hlbrooks/FireBot/PCB_docs/new_boardforfirebot.brd

## EAGLE design PCB_docs/new_boardforfirebot.brd (2021-12-12)

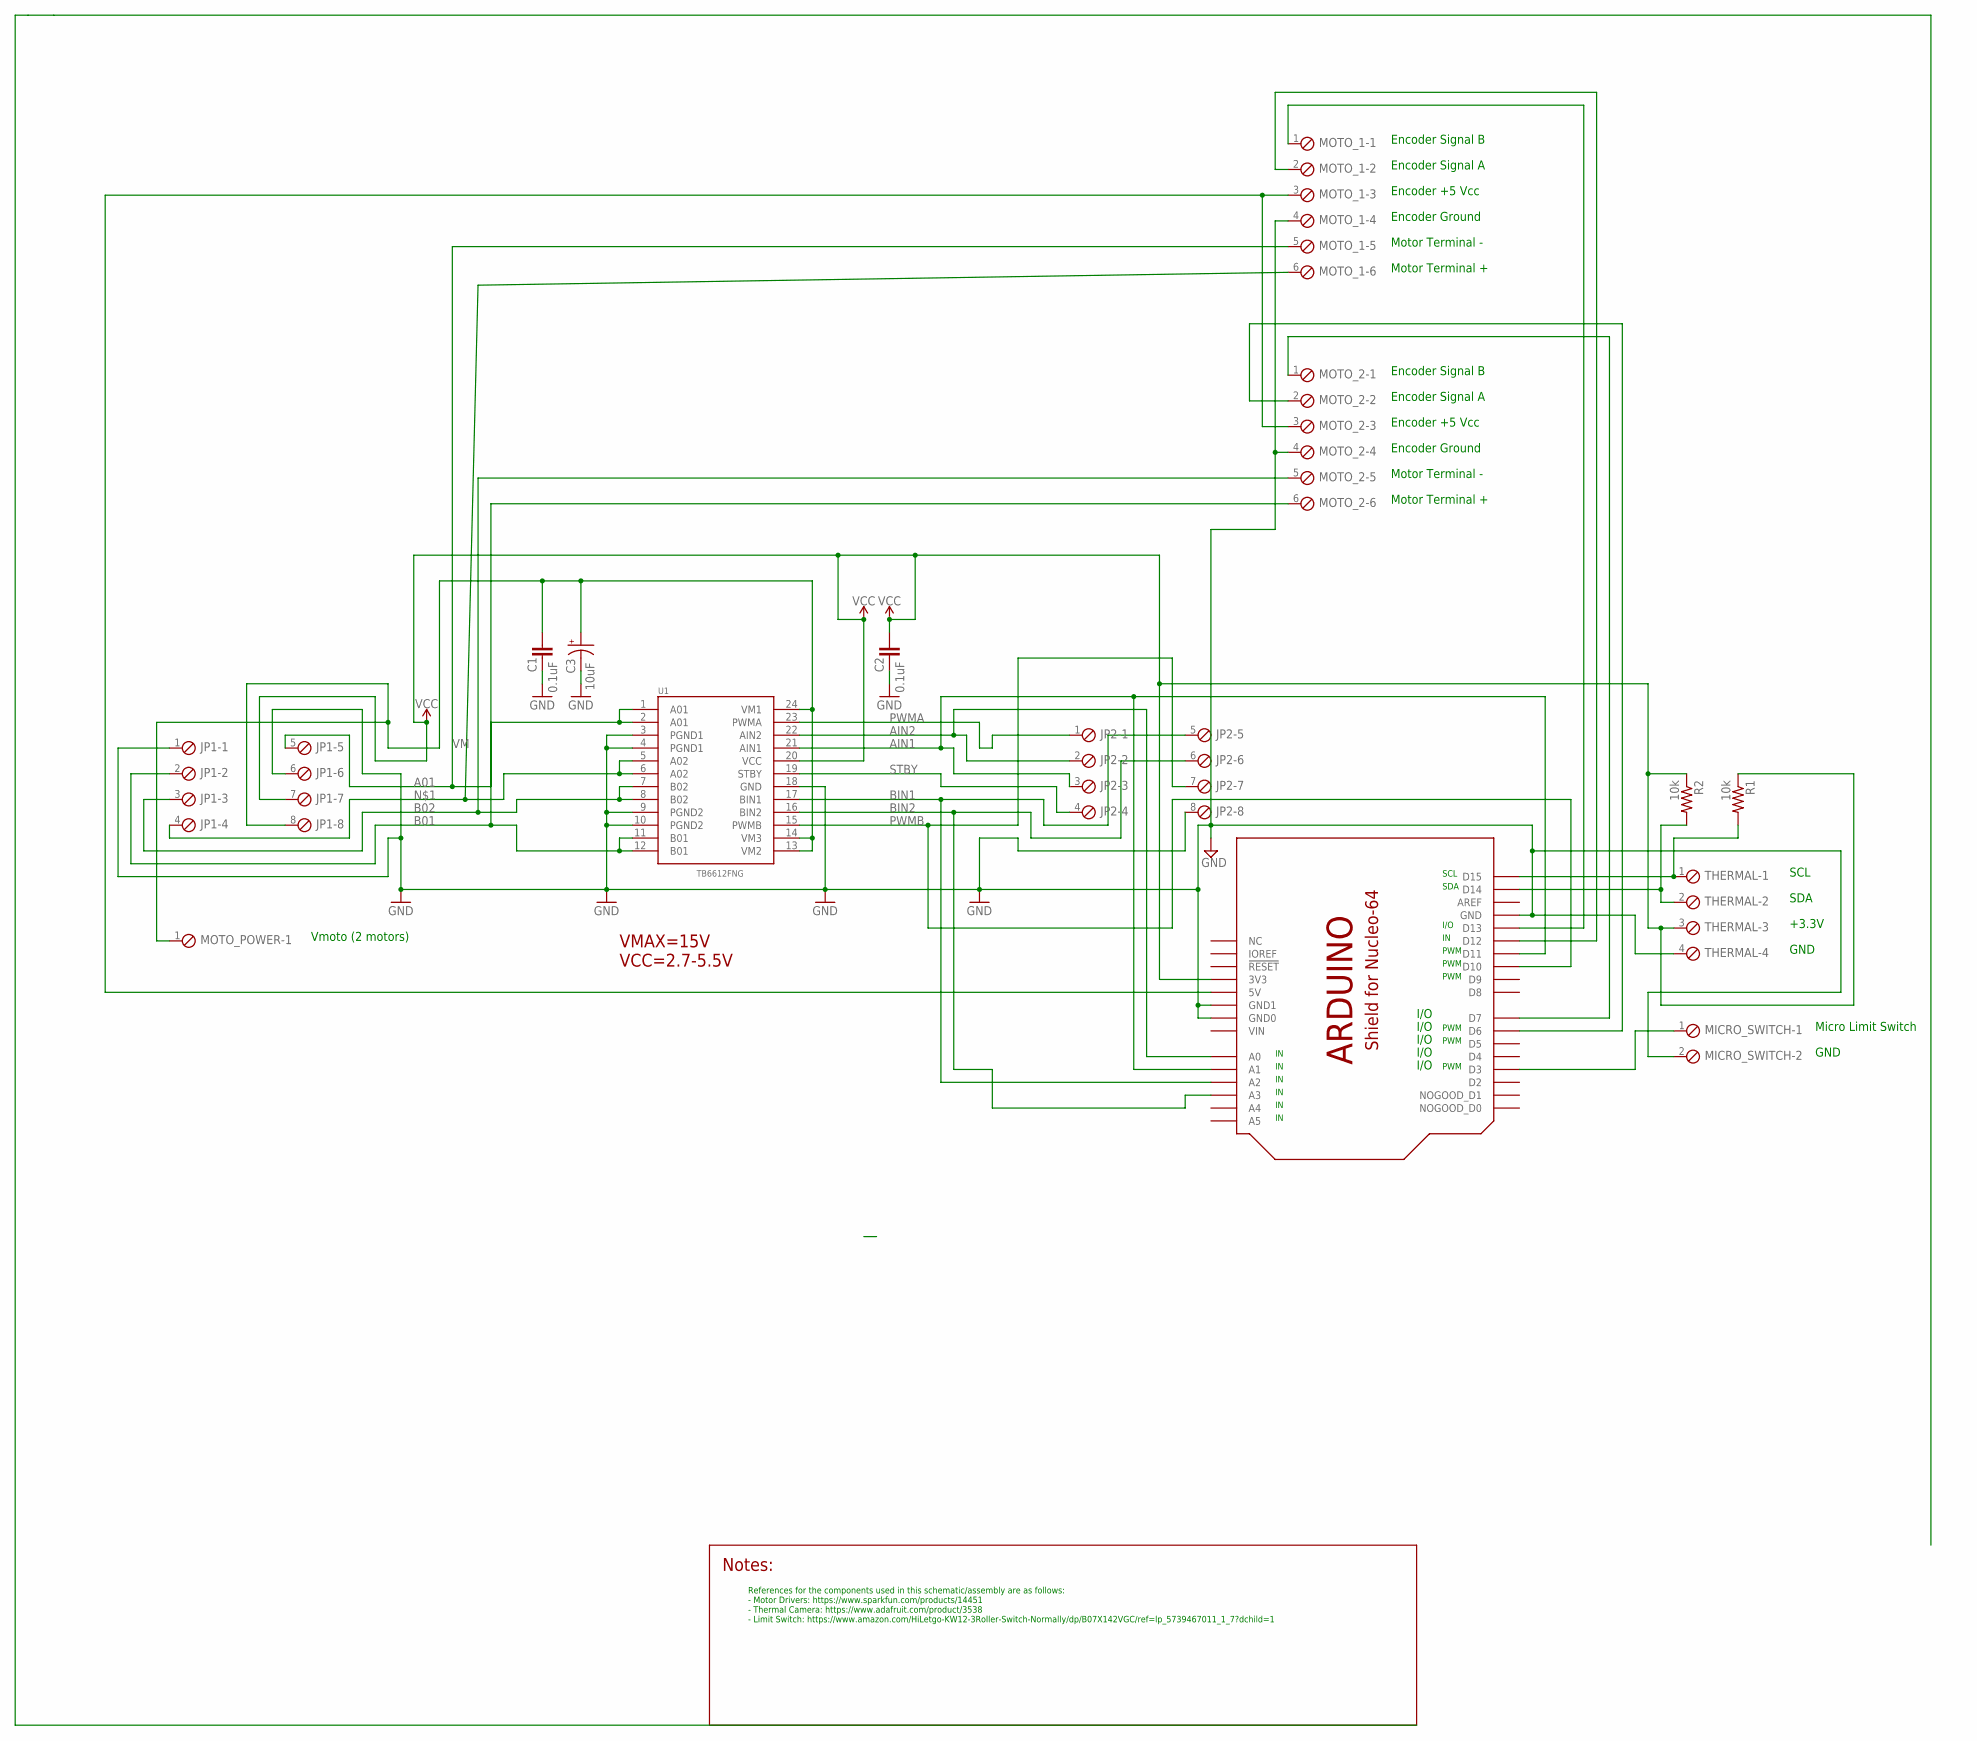
[picture p1: schematic new_boardforfirebot.sch]

Parts:
C1, C2: 0.1uF; 0402
C3: 10uF; EIA3528
JP1, JP2: SCREWTERM_8P_254; 8POL254
MICRO_SWITCH: SCREWTERM_2P_254; 2POL254
MOTO_1, MOTO_2: SCREWTERM_6P_254; 6POL254
MOTO_POWER: SCREWTERM_2P_254; 2POL254
R1, R2: 10k; R0805
THERMAL: SCREWTERM_4P_254; 4POL254
U1: TB6612FNG; SSOP24
U$1: SHIELD_FOR_NUCLE0_64_STANDARD; SHIELD_FOR_NUCLEO_64_STD

Connections:
A01: JP1.5, MOTO_1.5, U1.1 (A01), U1.2 (A01)
AIN1: JP2.3, U1.21 (AIN1), U$1.A1, U$1.D11
AIN2: JP2.2, U1.22 (AIN2), U$1.A0
B01: JP1.2, MOTO_2.6, U1.11 (B01), U1.12 (B01)
B02: JP1.3, MOTO_2.5, U1.7 (B02), U1.8 (B02)
BIN1: JP2.5, U1.17 (BIN1), U$1.A2
BIN2: JP2.6, U1.16 (BIN2), U$1.A3
GND: C1.2, C2.2, C3.C (-), JP1.1, JP1.6, JP2.8, MICRO_SWITCH.2, MOTO_1.4, MOTO_2.4, THERMAL.4, U1.3 (PGND1), U1.4 (PGND1), U1.9 (PGND2), U1.10 (PGND2), U1.18 (GND), U$1.GND, U$1.GND1 (GND0), U$1.GND2 (GND1)
unnamed: JP1.4, MOTO_1.6, U1.5 (A02), U1.6 (A02)
unnamed: MOTO_1.3, MOTO_2.3, U$1.5V
unnamed: MOTO_1.1, U$1.D13
unnamed: MOTO_1.2, U$1.D12
unnamed: MOTO_2.1, U$1.D7
unnamed: MOTO_2.2, U$1.D6
unnamed: R1.2, THERMAL.1, U$1.D15
unnamed: MICRO_SWITCH.1, U$1.D3
unnamed: R2.2, THERMAL.2, U$1.D14
PWMA: JP2.1, U1.23 (PWMA)
PWMB: JP2.7, U1.15 (PWMB), U$1.D10
STBY: JP2.4, U1.19 (STBY)
VCC: C2.1, JP1.7, R1.1, R2.1, THERMAL.3, U1.20 (VCC), U$1.3V (3V3)
VIN: U$1.VIN
VM: C1.1, C3.A (+), JP1.8, MOTO_POWER.1, U1.13 (VM2), U1.14 (VM3), U1.24 (VM1)

Notes on the sheet:
VMAX=15V VCC=2.7-5.5V
Encoder Signal B
Encoder Signal A
Encoder +5 Vcc
Encoder Ground
Motor Terminal -
Motor Terminal +
Vmoto (2 motors)
PWM
SCL
SDA
I/O
+3.3V
GND
Micro Limit Switch
References for the components used in this schematic/assembly are as follows: - Motor Drivers: https://www.sparkfun.com/products/14451 - Thermal Camera: https://www.adafruit.com/product/3538 - Limit Switch: https://www.amazon.com/HiLetgo-KW12-3Roller-Switch-Normally/dp/B07X142VGC/ref=lp_5739467011_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

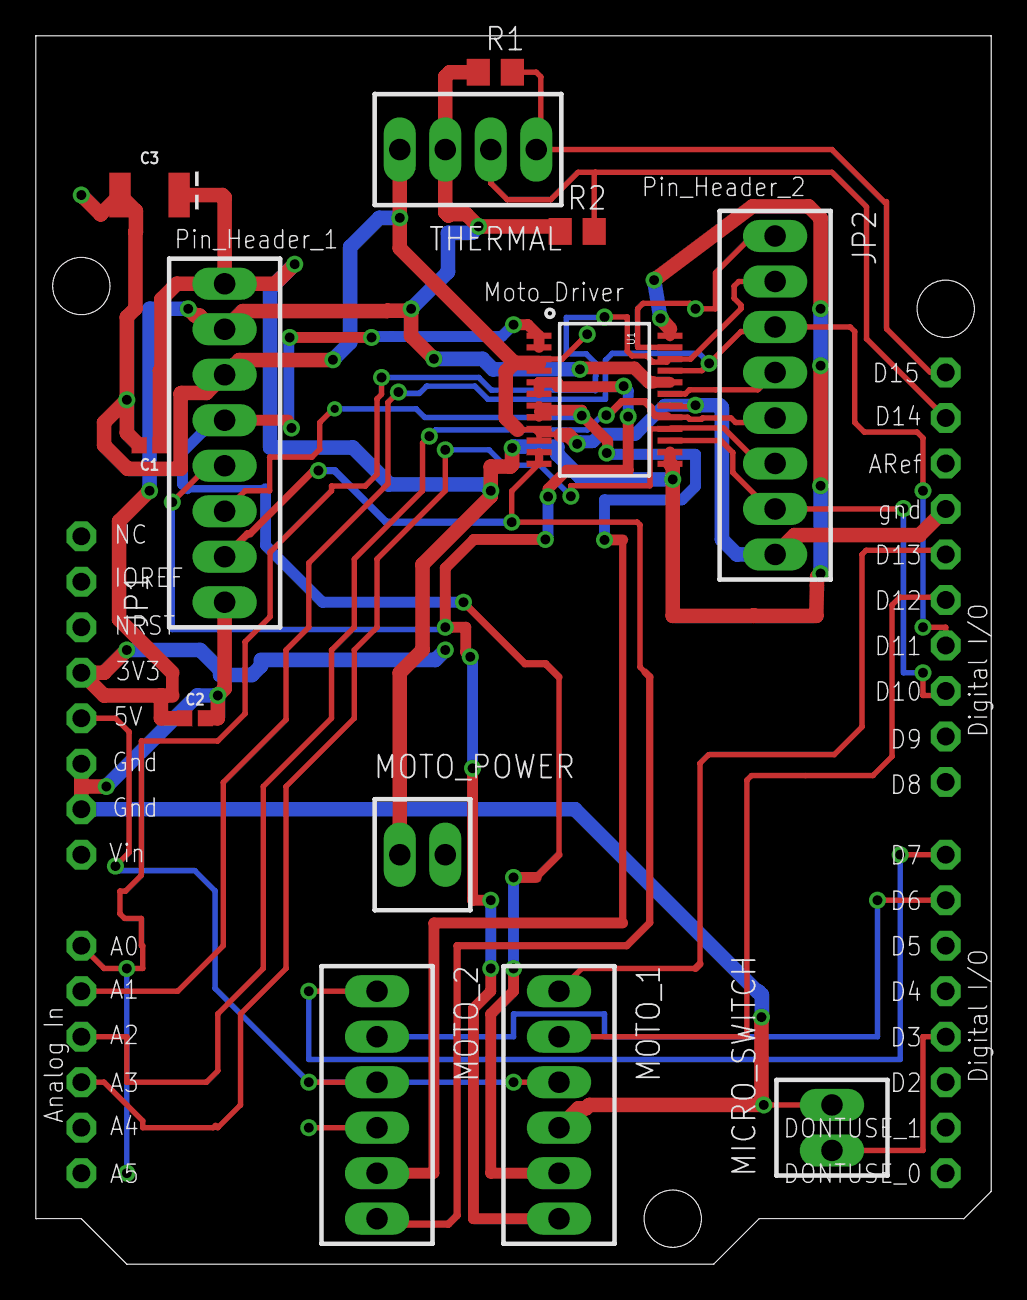
[picture p2: board new_boardforfirebot.brd from above]

Board: 2 copper layers, 53.3 x 68.6 mm, 14 parts (0 on the bottom side), 22 nets.
